medpar/DC/Documentos/Enunciado/1.png

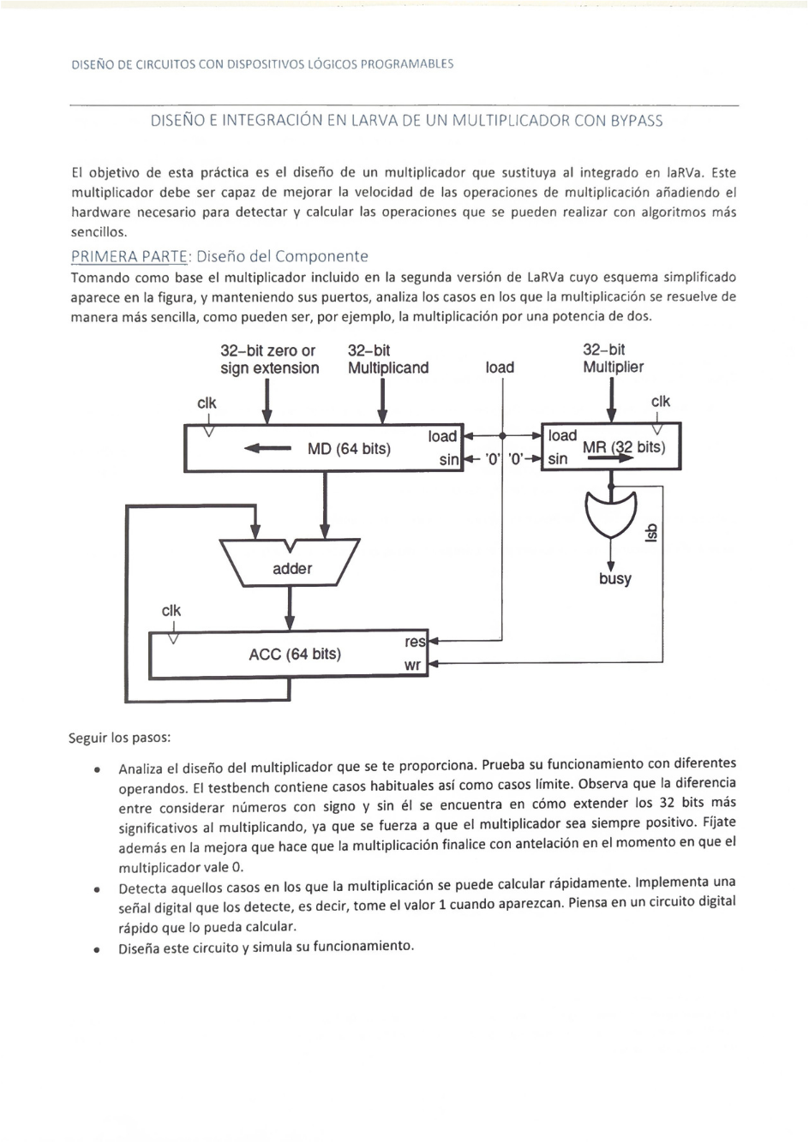
Documentos/Enunciado/1.png
