medpar/DC/Documentos/Enunciado/2.png

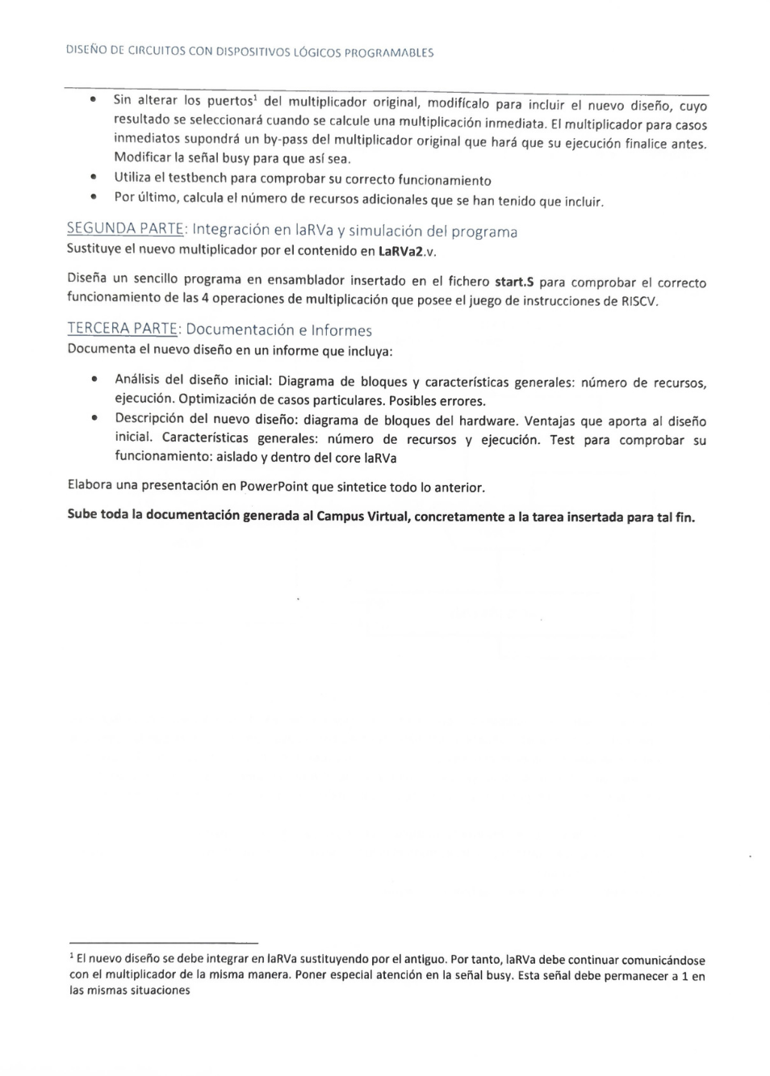
Documentos/Enunciado/2.png
