medpar/DC/Documentos/larva_v2/1.png

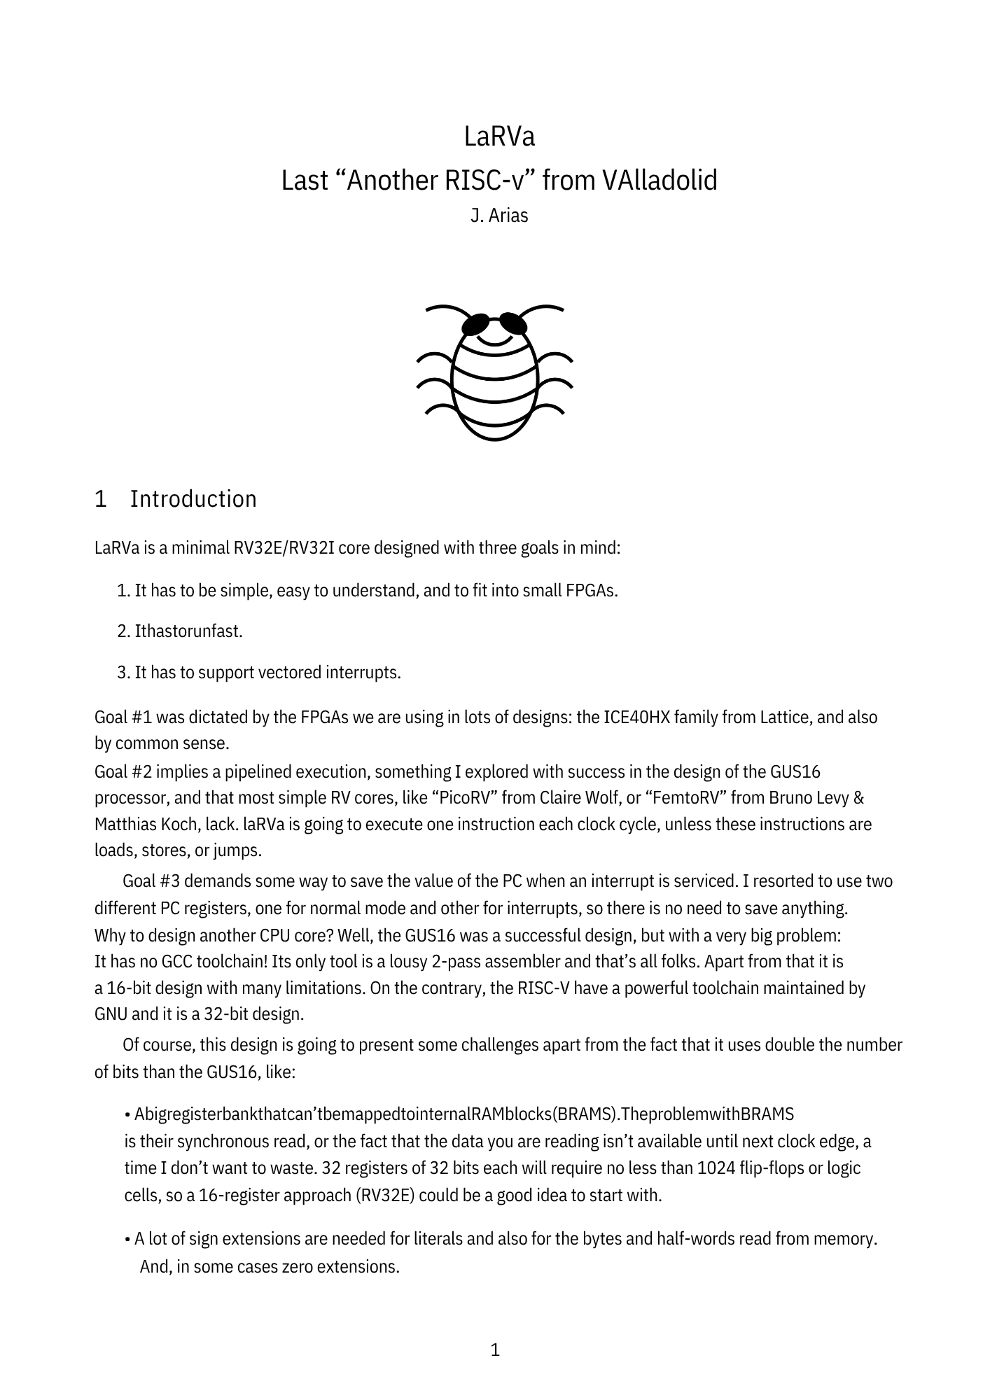
Documentos/larva_v2/1.png
