medpar/DC/Documentos/larva_v2/2.png

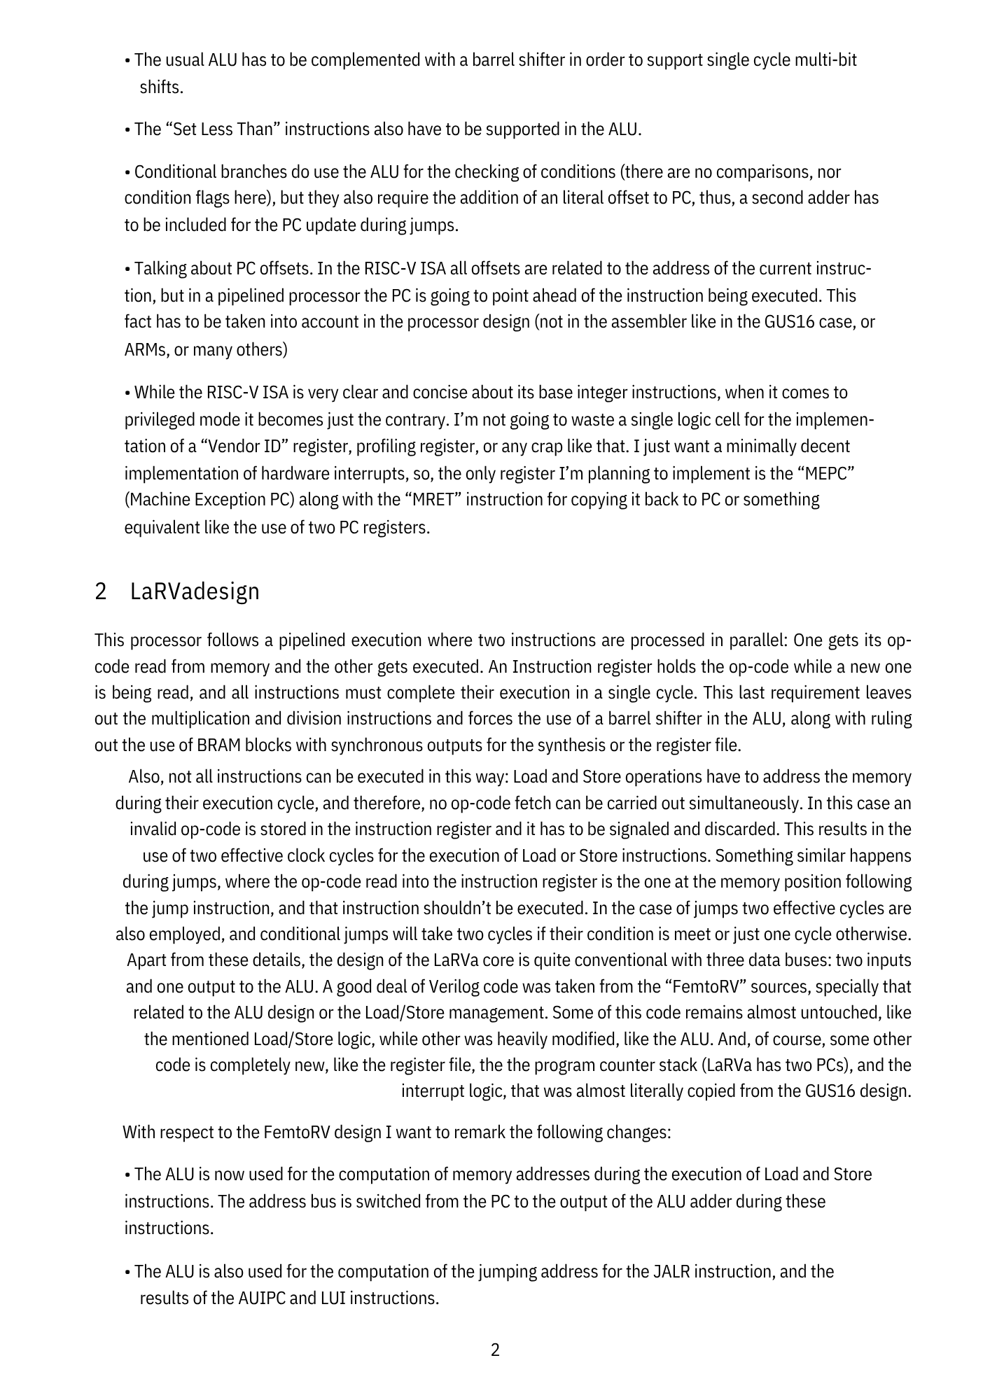
Documentos/larva_v2/2.png
