medpar/DC/Documentos/larva_v2/3.png

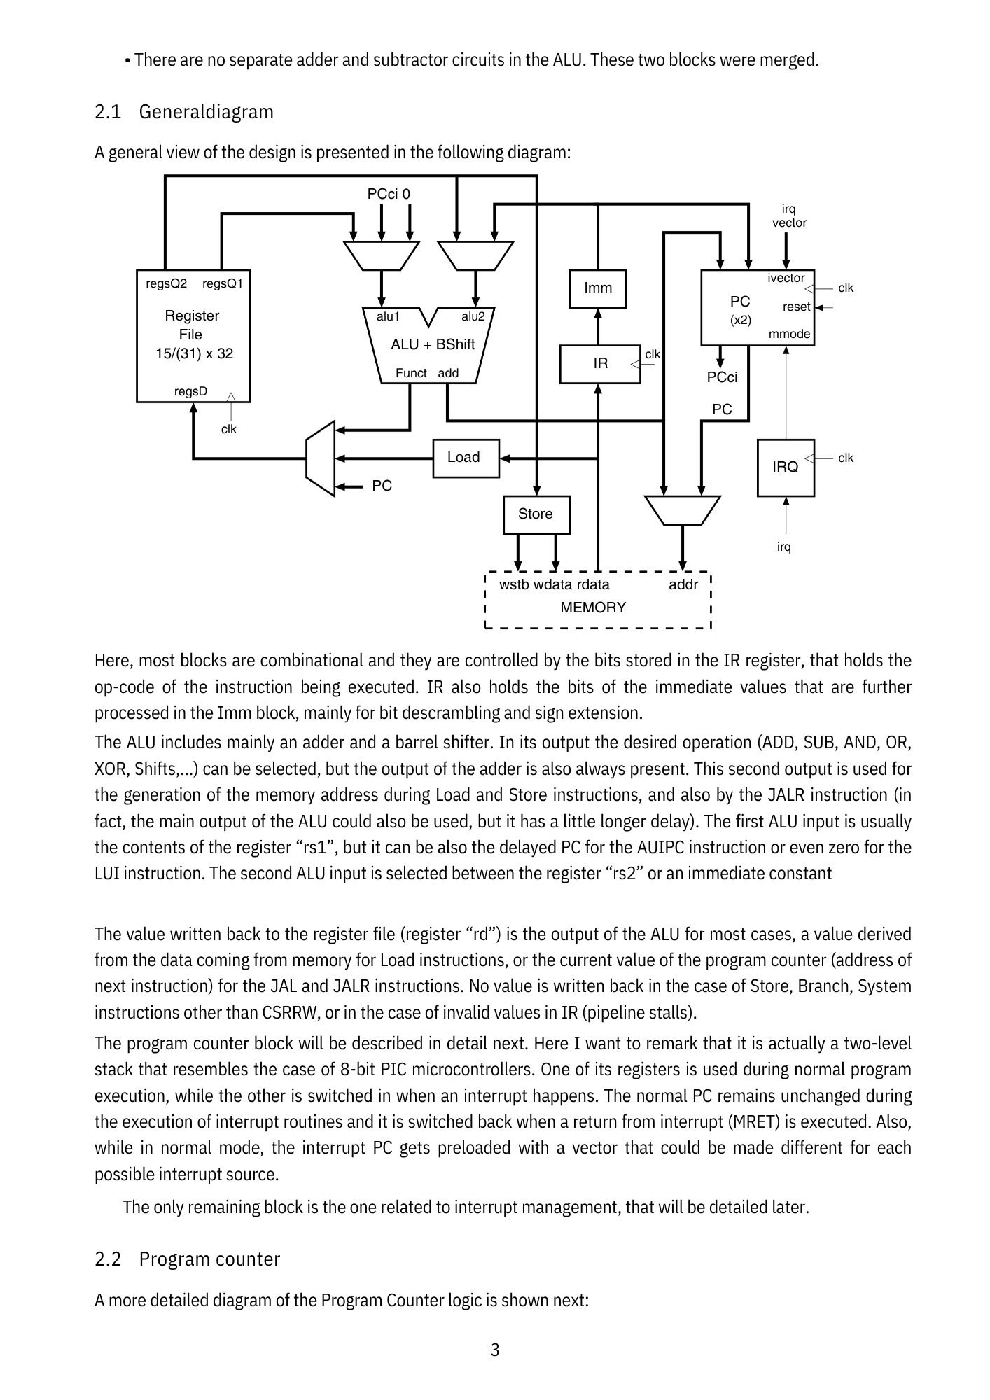
Documentos/larva_v2/3.png
