medpar/DC/Documentos/larva_v2/4.png

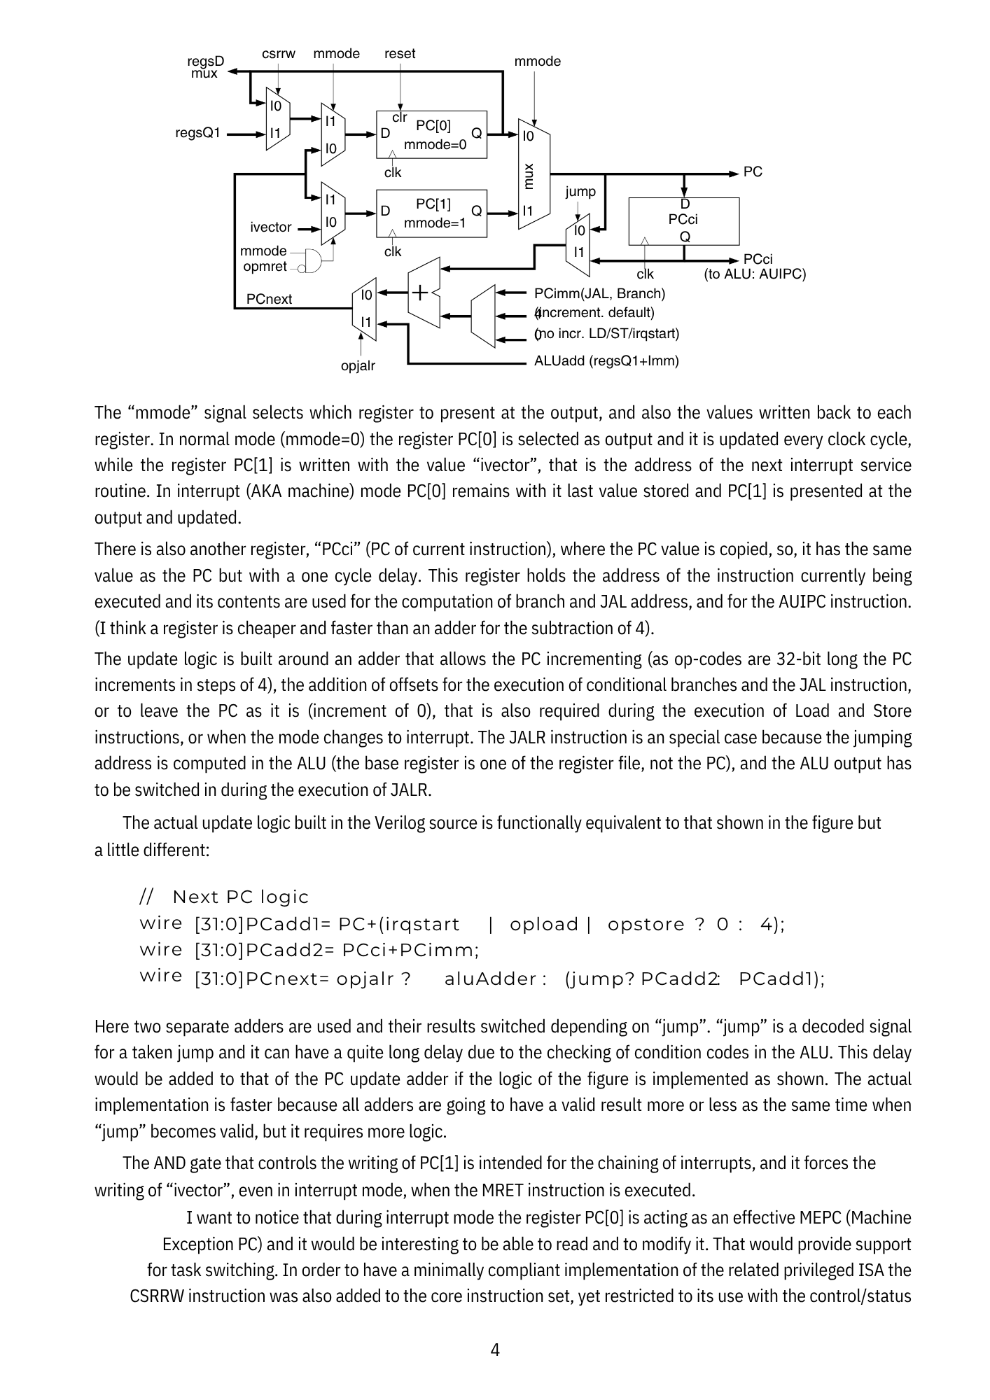
Documentos/larva_v2/4.png
