medpar/DC/Documentos/larva_v2/5.png

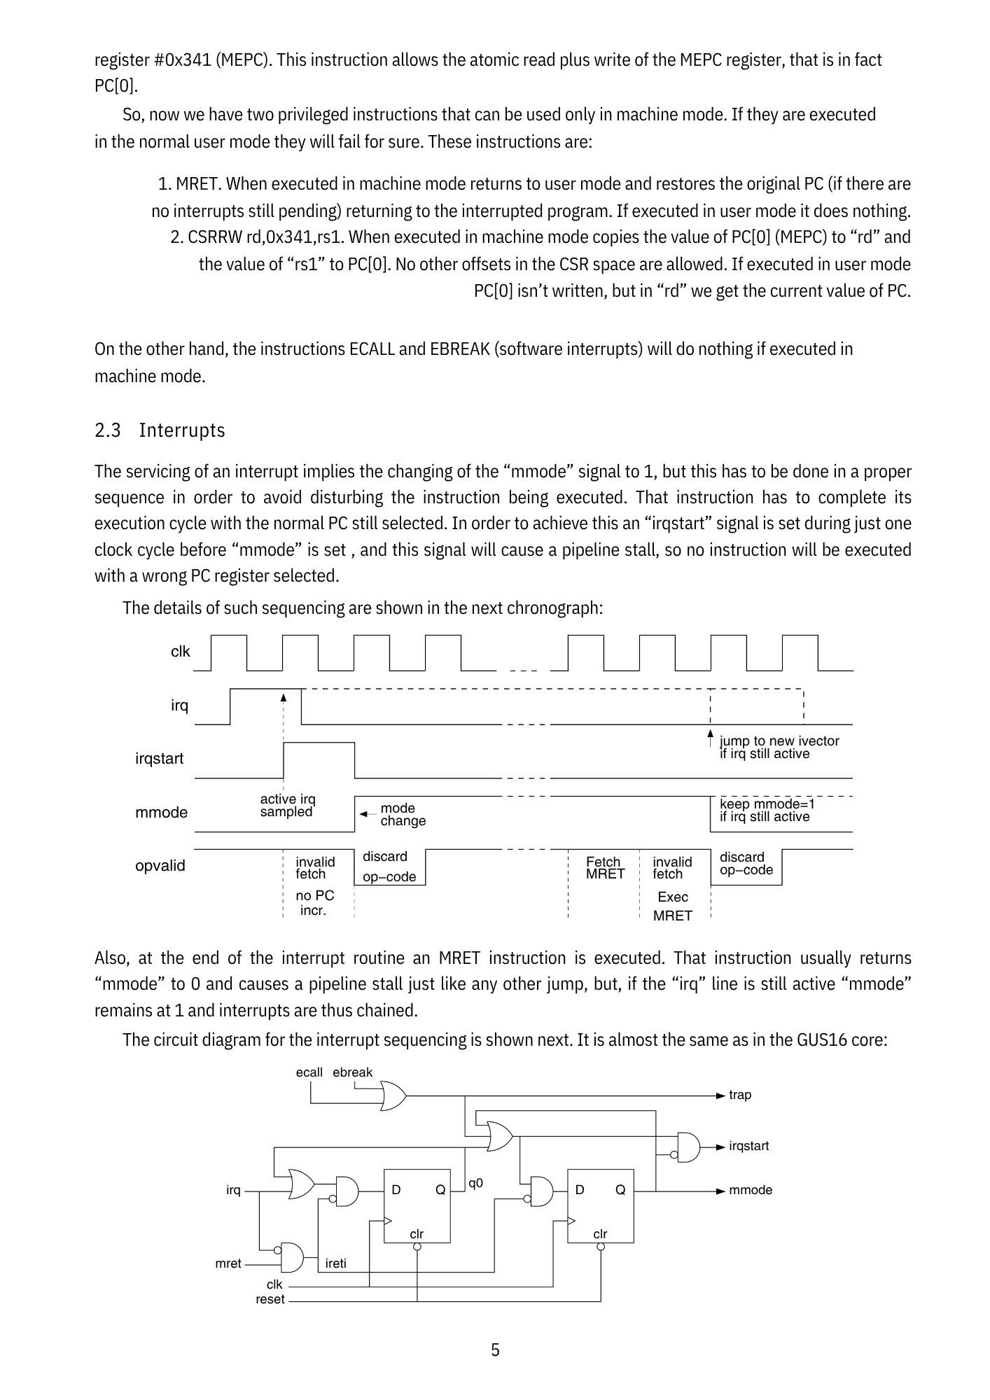
Documentos/larva_v2/5.png
