medpar/DC/Documentos/larva_v2/6.png

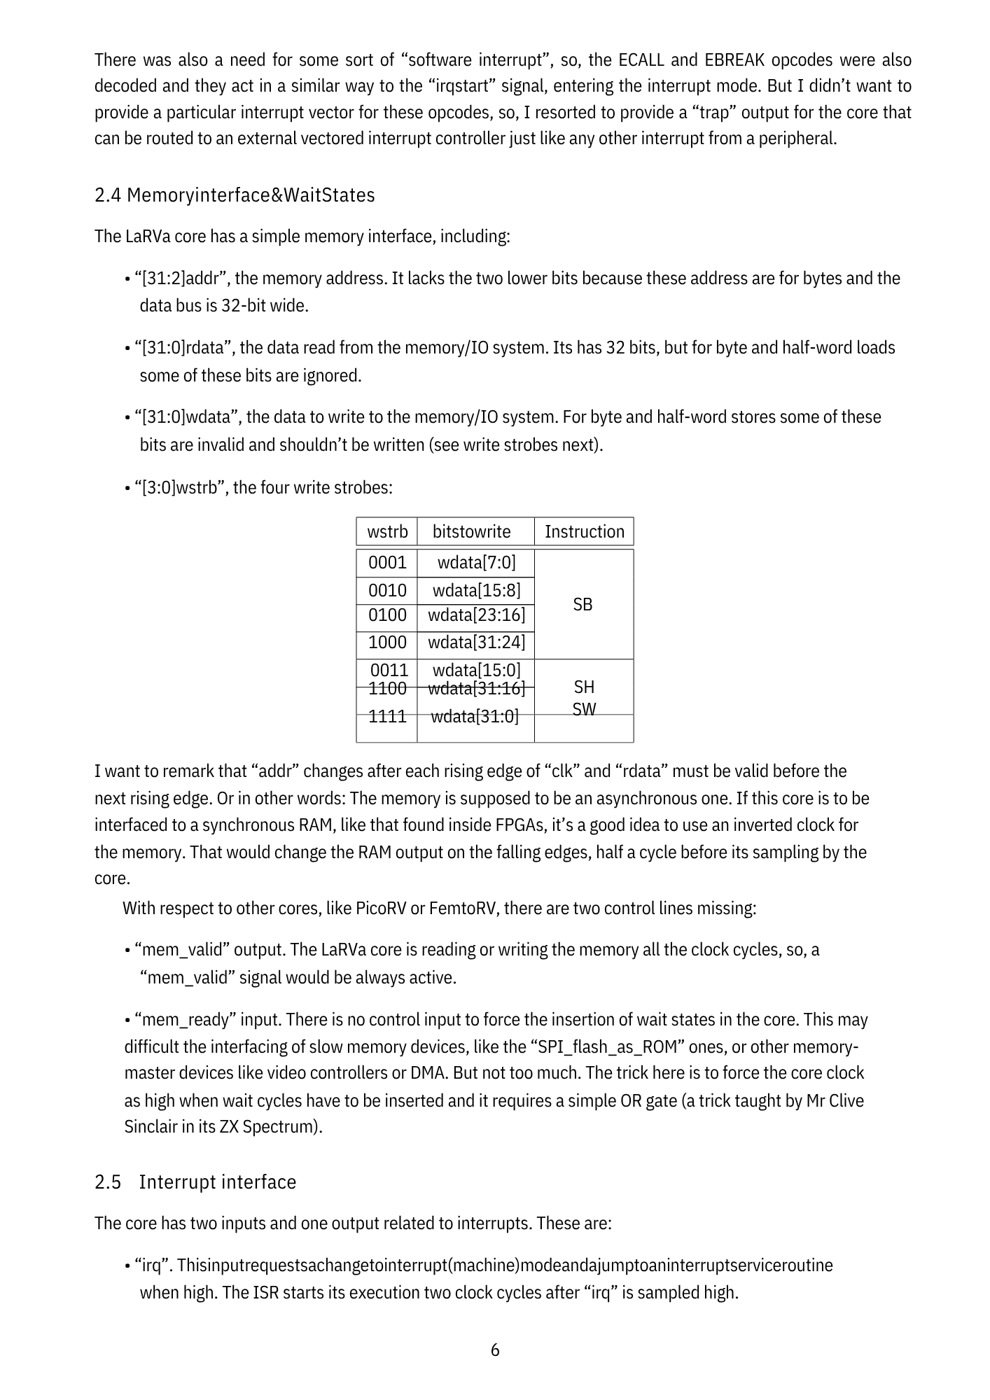
Documentos/larva_v2/6.png
