medpar/DC/Documentos/larva_v2/7.png

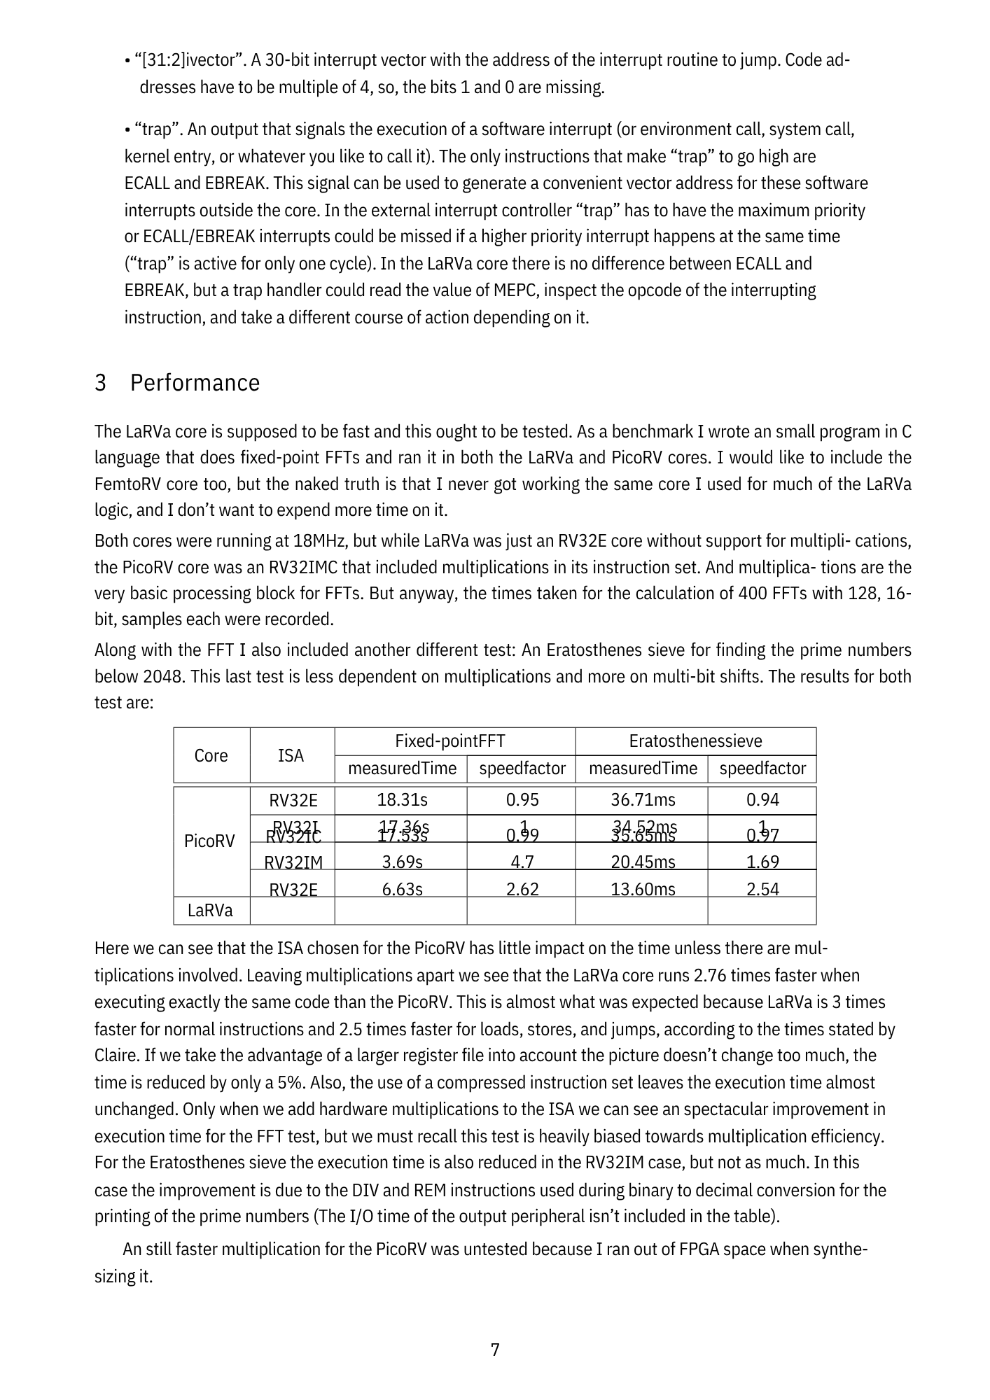
Documentos/larva_v2/7.png
