medpar/DC/Documentos/larva_v2/8.png

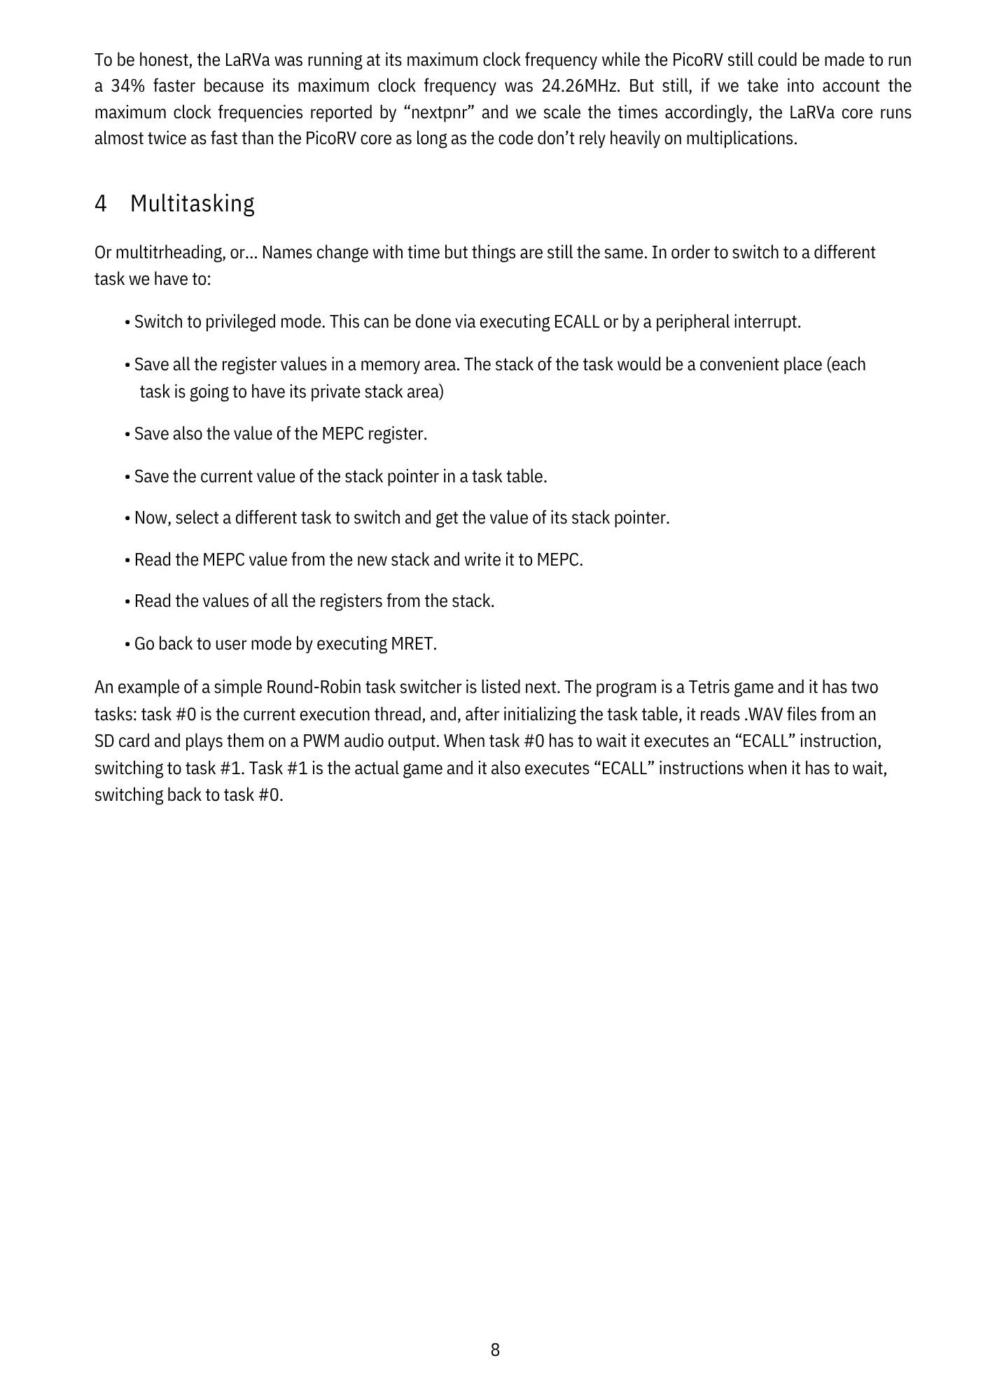
Documentos/larva_v2/8.png
