medpar/DC/Documentos/larva_v2/9.png

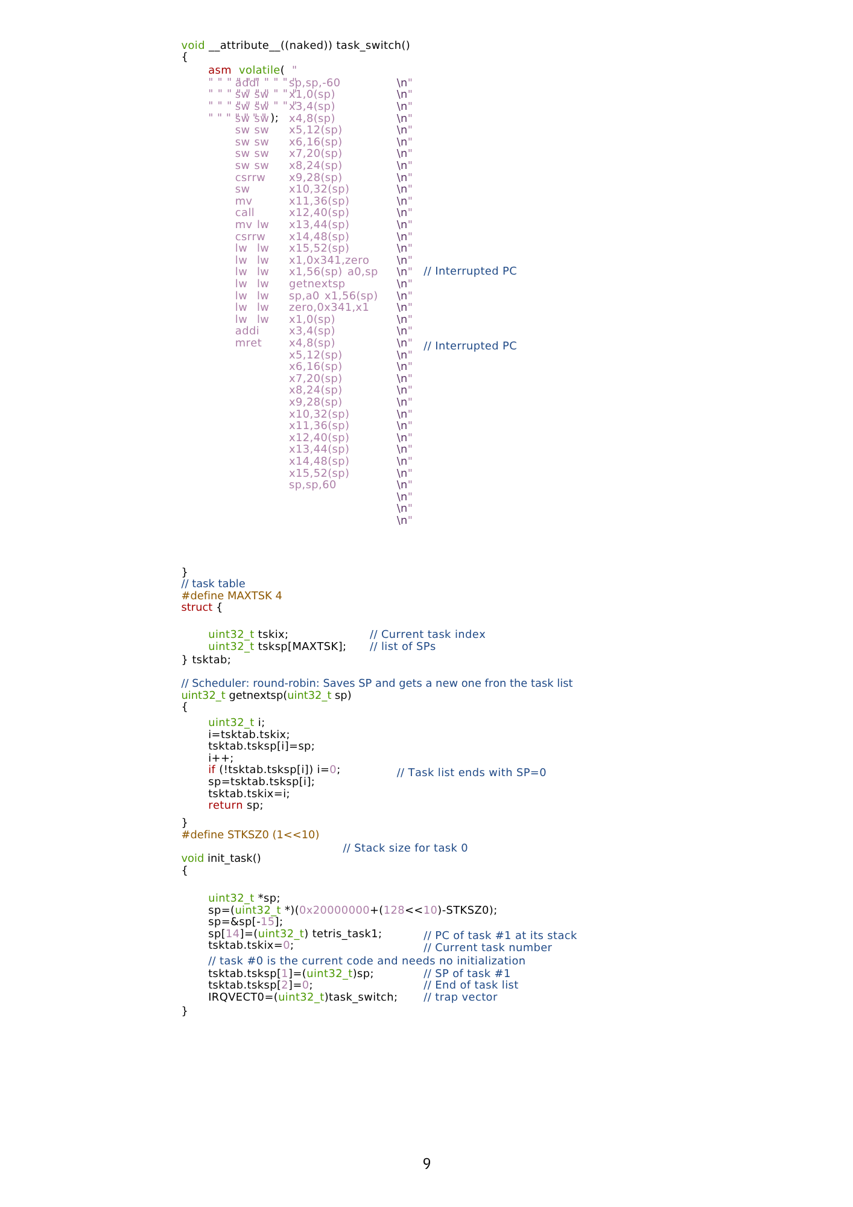
Documentos/larva_v2/9.png
