medpar/DC/Documentos/larva_v2/10.png

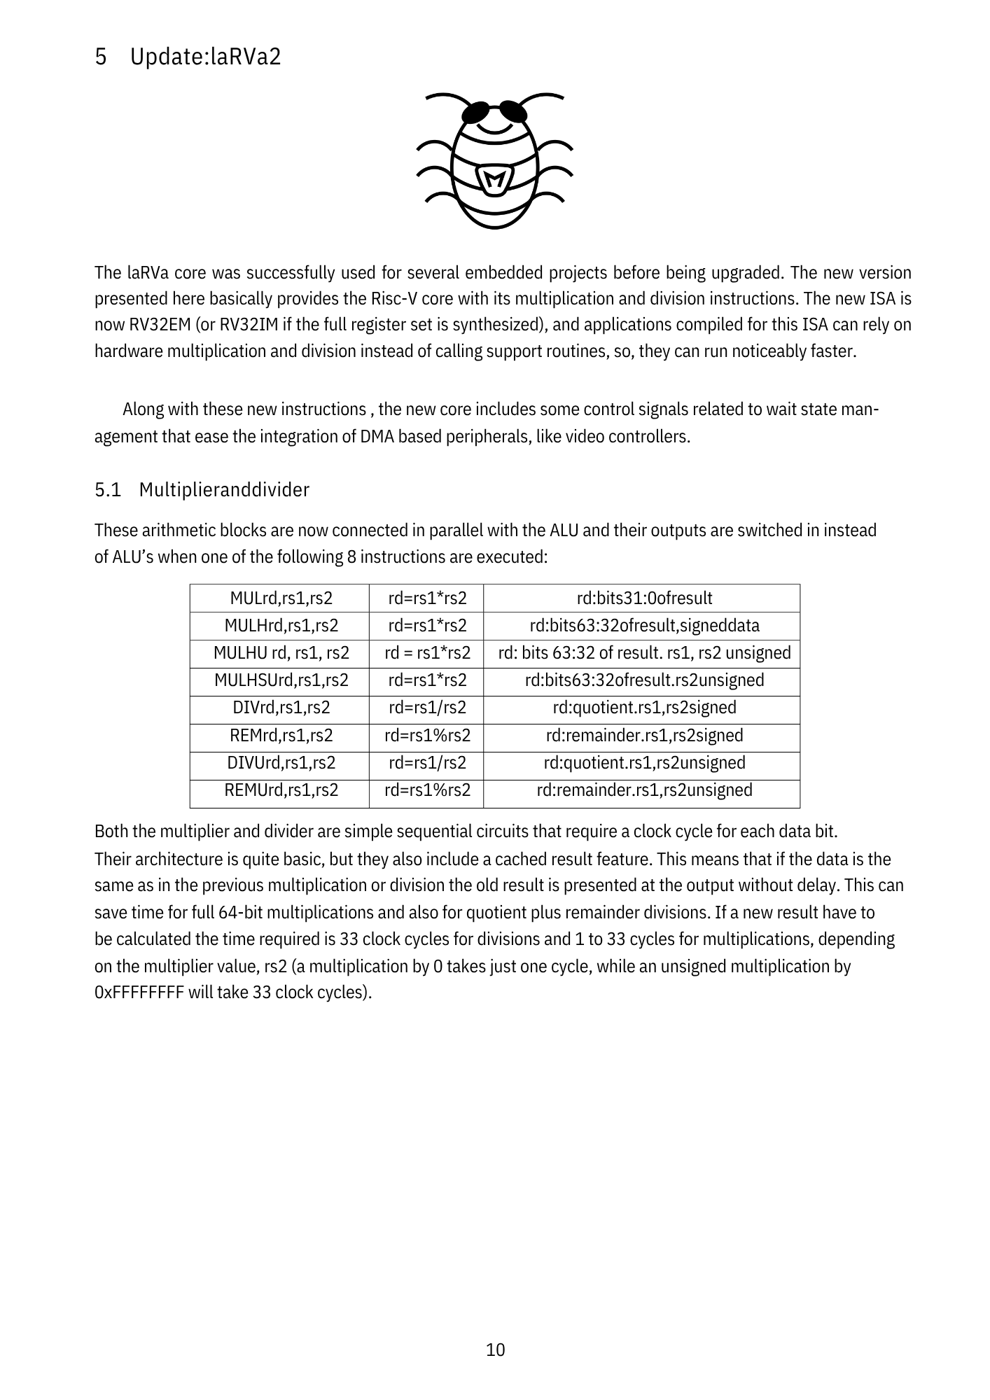
Documentos/larva_v2/10.png
