medpar/DC/Documentos/larva_v2/11.png

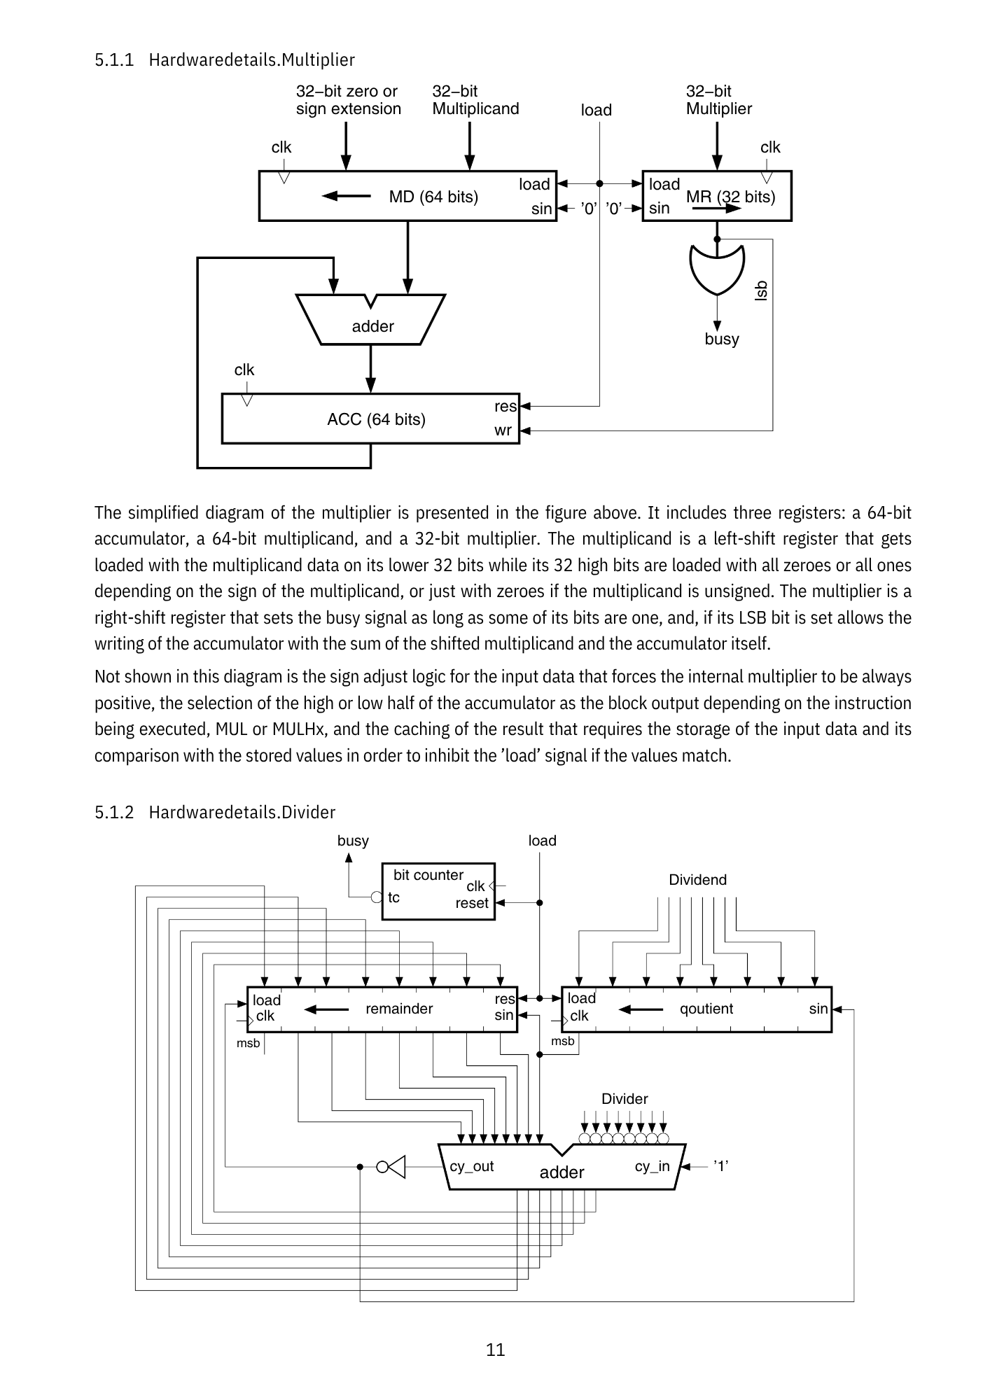
Documentos/larva_v2/11.png
