medpar/DC/Documentos/larva_v2/12.png

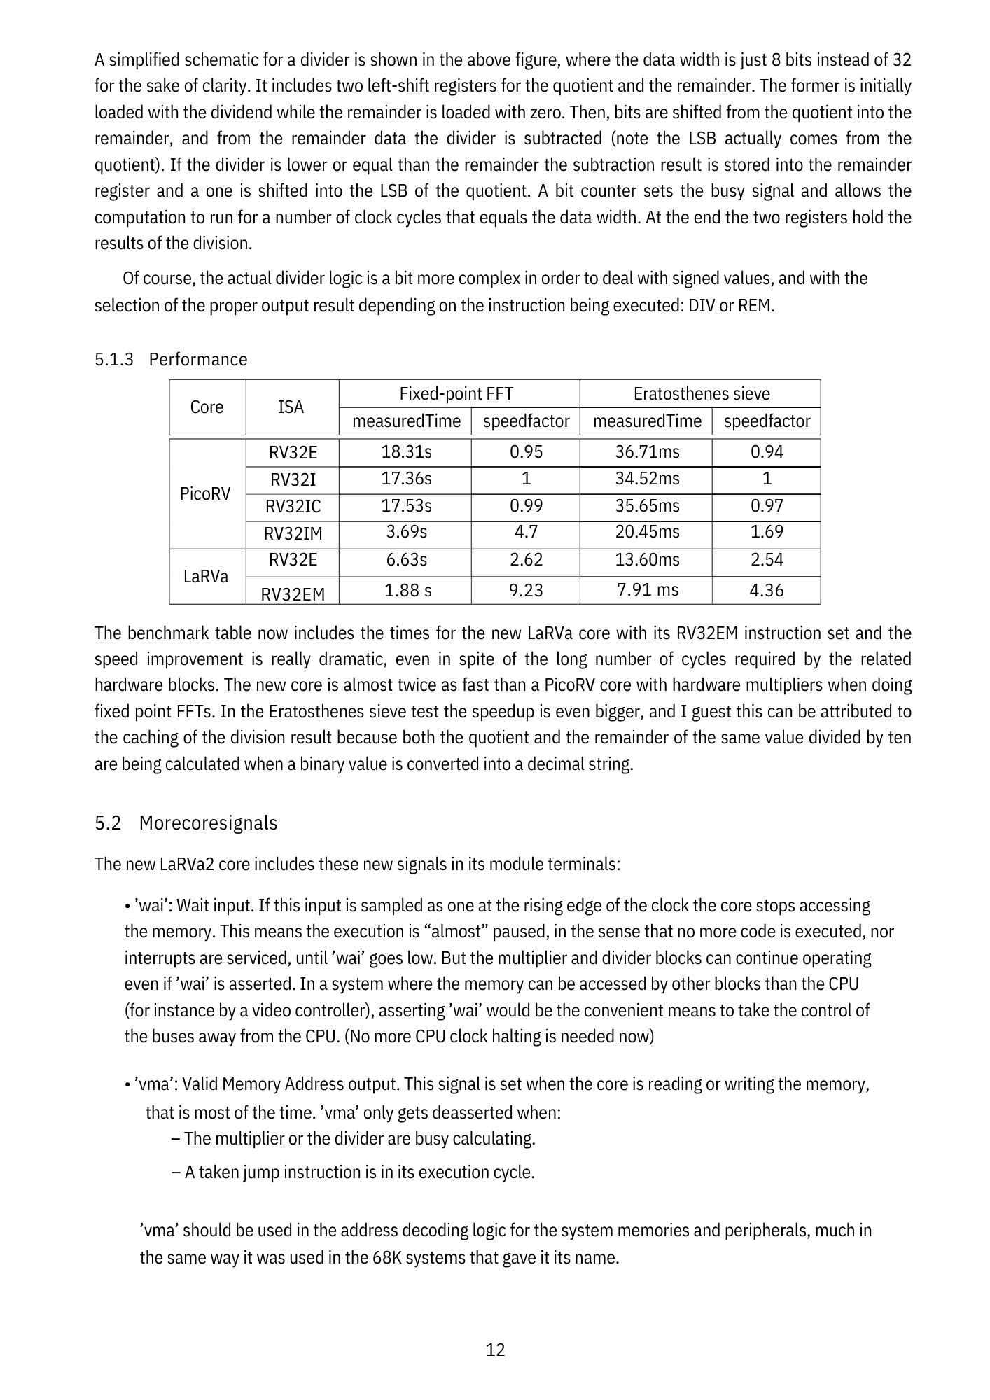
Documentos/larva_v2/12.png
