medpar/DC/Documentos/larva_v2/13.png

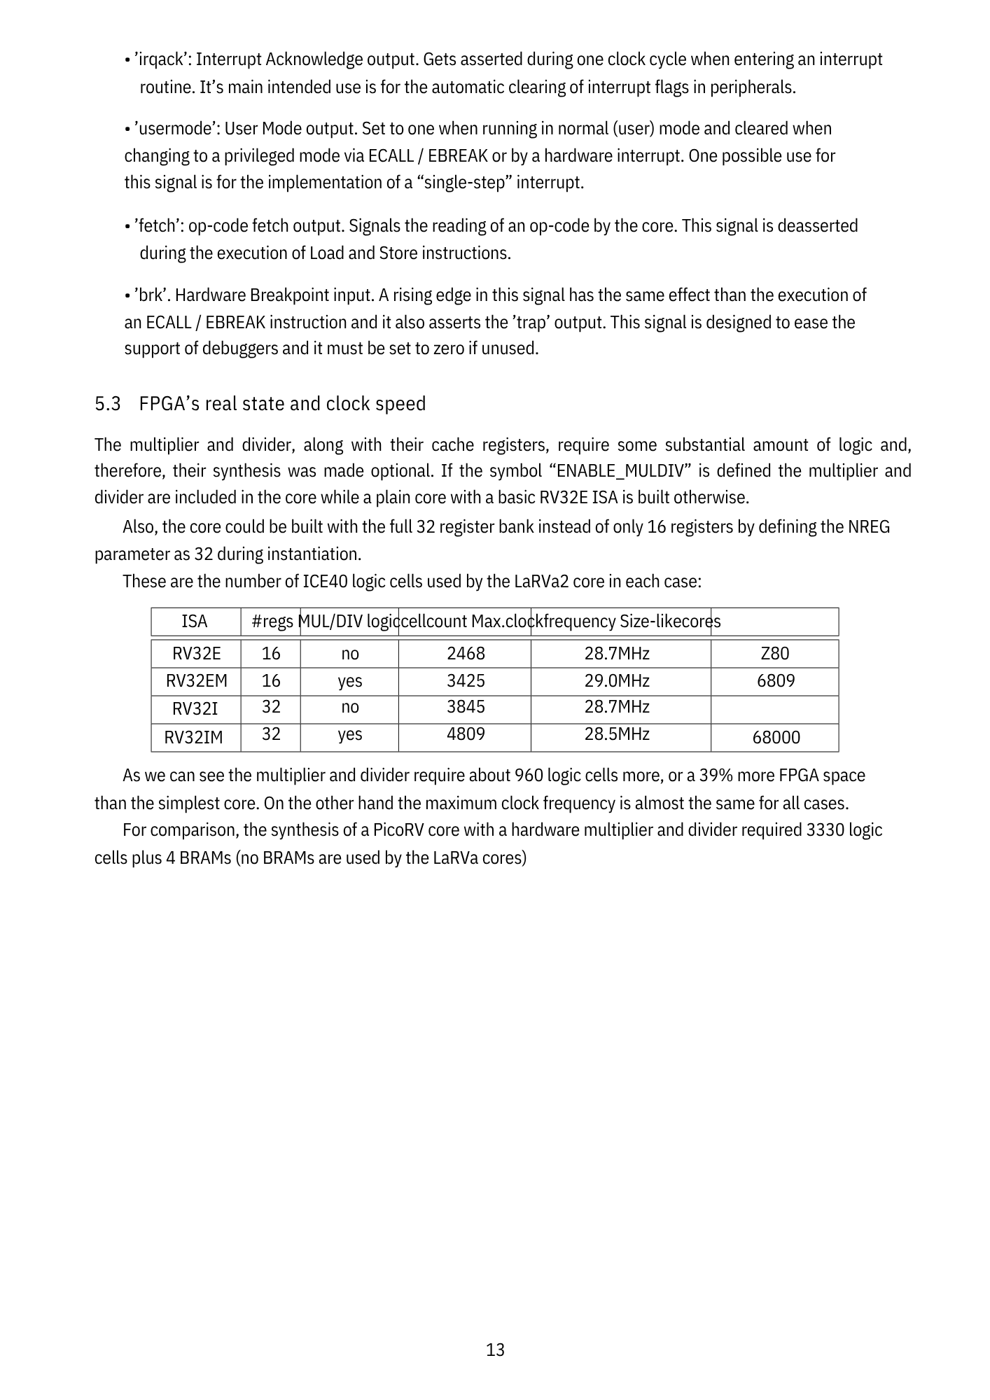
Documentos/larva_v2/13.png
