medpar/DC/Firmware/tv.c

#define NFFT 400

#define L2NS (7)
#define NSAMPLES (1<<L2NS)

unsigned int nmul=0,nadd=0;

typedef short fixed;

int fix_fft(fixed *fr, fixed *fi, int m, int inverse);
void window(fixed *fr, int n);
void fix_loud(fixed *loud, fixed *fr, fixed *fi, int n, int scale_shift);

/*      fix_fft.c - Fixed-point Fast Fourier Transform  */
/*
        fix_fft()       perform FFT or inverse FFT
        window()        applies a Hanning window to the (time) input
        fix_loud()      calculates the loudness of the signal, for
                        each freq point. Result is an integer array,
                        units are dB (values will be negative).
        iscale()        scale an integer value by (numer/denom).
        fix_mpy()       perform fixed-point multiplication.
        Sinewave[1024]  sinewave normalized to 32767 (= 1.0).
        Loudampl2[100]  Square of Amplitudes for lopudnesses from 0 to -99 dB.
        Low_pass        Low-pass filter, cutoff at sample_freq / 4.


        All data are fixed-point short integers, in which
        -32768 to +32768 represent -1.0 to +1.0. Integer arithmetic
        is used for speed, instead of the more natural floating-point.

        For the forward FFT (time -> freq), fixed scaling is
        performed to prevent arithmetic overflow, and to map a 0dB
        sine/cosine wave (i.e. amplitude = 32767) to two -6dB freq
        coefficients; the one in the lower half is reported as 0dB
        by fix_loud(). The return value is always 0.

        For the inverse FFT (freq -> time), fixed scaling cannot be
        done, as two 0dB coefficients would sum to a peak amplitude of
        64K, overflowing the 32k range of the fixed-point integers.
        Thus, the fix_fft() routine performs variable scaling, and
        returns a value which is the number of bits LEFT by which
        the output must be shifted to get the actual amplitude
        (i.e. if fix_fft() returns 3, each value of fr[] and fi[]
        must be multiplied by 8 (2**3) for proper scaling.
        Clearly, this cannot be done within the fixed-point short
        integers. In practice, if the result is to be used as a
        filter, the scale_shift can usually be ignored, as the
        result will be approximately correctly normalized as is.


        TURBO C, any memory model; uses inline assembly for speed
        and for carefully-scaled arithmetic.

        Written by:  Tom Roberts  11/8/89
        Made portable:  Malcolm Slaney 12/15/94 malcolm@interval.com

                Timing on a Macintosh PowerBook 180.... (using Symantec C6.0)
                        fix_fft (1024 points)             8 ticks
                        fft (1024 points - Using SANE)  112 Ticks
                        fft (1024 points - Using FPU)    11

*/

#define N_WAVE          1024    /* dimension of Sinewave[] */
#define LOG2_N_WAVE     10      /* log2(N_WAVE) */

#ifndef fixed
#define fixed int16_t
#endif


#if N_WAVE != 1024
        ERROR: N_WAVE != 1024
#endif
const fixed Sinewave[1024] = {
      0,    201,    402,    603,    804,   1005,   1206,   1406,
   1607,   1808,   2009,   2209,   2410,   2610,   2811,   3011,
   3211,   3411,   3611,   3811,   4011,   4210,   4409,   4608,
   4807,   5006,   5205,   5403,   5601,   5799,   5997,   6195,
   6392,   6589,   6786,   6982,   7179,   7375,   7571,   7766,
   7961,   8156,   8351,   8545,   8739,   8932,   9126,   9319,
   9511,   9703,   9895,  10087,  10278,  10469,  10659,  10849,
  11038,  11227,  11416,  11604,  11792,  11980,  12166,  12353,
  12539,  12724,  12909,  13094,  13278,  13462,  13645,  13827,
  14009,  14191,  14372,  14552,  14732,  14911,  15090,  15268,
  15446,  15623,  15799,  15975,  16150,  16325,  16499,  16672,
  16845,  17017,  17189,  17360,  17530,  17699,  17868,  18036,
  18204,  18371,  18537,  18702,  18867,  19031,  19194,  19357,
  19519,  19680,  19840,  20000,  20159,  20317,  20474,  20631,
  20787,  20942,  21096,  21249,  21402,  21554,  21705,  21855,
  22004,  22153,  22301,  22448,  22594,  22739,  22883,  23027,
  23169,  23311,  23452,  23592,  23731,  23869,  24006,  24143,
  24278,  24413,  24546,  24679,  24811,  24942,  25072,  25201,
  25329,  25456,  25582,  25707,  25831,  25954,  26077,  26198,
  26318,  26437,  26556,  26673,  26789,  26905,  27019,  27132,
  27244,  27355,  27466,  27575,  27683,  27790,  27896,  28001,
  28105,  28208,  28309,  28410,  28510,  28608,  28706,  28802,
  28897,  28992,  29085,  29177,  29268,  29358,  29446,  29534,
  29621,  29706,  29790,  29873,  29955,  30036,  30116,  30195,
  30272,  30349,  30424,  30498,  30571,  30643,  30713,  30783,
  30851,  30918,  30984,  31049,
  31113,  31175,  31236,  31297,
  31356,  31413,  31470,  31525,  31580,  31633,  31684,  31735,
  31785,  31833,  31880,  31926,  31970,  32014,  32056,  32097,
  32137,  32176,  32213,  32249,  32284,  32318,  32350,  32382,
  32412,  32441,  32468,  32495,  32520,  32544,  32567,  32588,
  32609,  32628,  32646,  32662,  32678,  32692,  32705,  32717,
  32727,  32736,  32744,  32751,  32757,  32761,  32764,  32766,
  32767,  32766,  32764,  32761,  32757,  32751,  32744,  32736,
  32727,  32717,  32705,  32692,  32678,  32662,  32646,  32628,
  32609,  32588,  32567,  32544,  32520,  32495,  32468,  32441,
  32412,  32382,  32350,  32318,  32284,  32249,  32213,  32176,
  32137,  32097,  32056,  32014,  31970,  31926,  31880,  31833,
  31785,  31735,  31684,  31633,  31580,  31525,  31470,  31413,
  31356,  31297,  31236,  31175,  31113,  31049,  30984,  30918,
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
};

/*
        fix_mpy() - fixed-point multiplication
*/
extern inline fixed fix_mpy(fixed a, fixed b)
{
return ((long)a*(long)b)>>15;

}

/*
        fix_fft() - perform fast Fourier transform.

        if n>0 FFT is done, if n<0 inverse FFT is done
        fr[n],fi[n] are real,imaginary arrays, INPUT AND RESULT.
        size of data = 2**m
        set inverse to 0=dft, 1=idft
*/
int fix_fft(fixed fr[], fixed fi[], int m, int inverse)
{
        int mr,nn,i,j,l,k,istep, n, scale, shift;
        fixed qr,qi,tr,ti,wr,wi,t;

                n = 1<<m;

        if(n > N_WAVE)
                return -1;

        mr = 0;
        nn = n - 1;
        scale = 0;

        /* decimation in time - re-order data */
        for(m=1; m<=nn; ++m) {
                l = n;
                do {
                        l >>= 1;
                } while(mr+l > nn);
                mr = (mr & (l-1)) + l;

                if(mr <= m) continue;
                tr = fr[m];
                fr[m] = fr[mr];
                fr[mr] = tr;
                ti = fi[m];
                fi[m] = fi[mr];
                fi[mr] = ti;
        }

        l = 1;
        k = LOG2_N_WAVE-1;
        while(l < n) {
                if(inverse) {
                        /* variable scaling, depending upon data */
                        shift = 0;
                        for(i=0; i<n; ++i) {
                                j = fr[i];
                                if(j < 0)
                                        j = -j;
                                m = fi[i];
                                if(m < 0)
                                        m = -m;
                                if(j > 16383 || m > 16383) {
                                        shift = 1;
                                        break;
                                }
                        }
                        if(shift)
                                ++scale;
                } else {
                        /* fixed scaling, for proper normalization -
                           there will be log2(n) passes, so this
                           results in an overall factor of 1/n,
                           distributed to maximize arithmetic accuracy. */
                        shift = 1;
                }
                /* it may not be obvious, but the shift will be performed
                   on each data point exactly once, during this pass. */
                istep = l << 1;
                for(m=0; m<l; ++m) {
                        j = m << k;
                        /* 0 <= j < N_WAVE/2 */
                        wr =  Sinewave[j+N_WAVE/4];
                        wi = -Sinewave[j];
                        if(inverse)
                                wi = -wi;
                        if(shift) {
                                wr >>= 1;
                                wi >>= 1;
                        }
                        for(i=m; i<n; i+=istep) {
                                j = i + l;
                                        tr = fix_mpy(wr,fr[j]) - fix_mpy(wi,fi[j]);
                                        ti = fix_mpy(wr,fi[j]) + fix_mpy(wi,fr[j]);
                                qr = fr[i];
                                qi = fi[i];
                                if(shift) {
                                        qr >>= 1;
                                        qi >>= 1;
                                }
                                fr[j] = qr - tr;
                                fi[j] = qi - ti;
                                fr[i] = qr + tr;
                                fi[i] = qi + ti;
                                //nmul+=4; nadd+=6;
                        }
                }
                --k;
                l = istep;
        }

        //printf("nmul=%d nadd=%d\n",nmul,nadd);
        //exit(0);
        return scale;
}

static unsigned long _srand=12345;
int _rand()
{
    _srand=_srand* 1103515245 + 12345;
    return (_srand>>16)&0x7fff;
}

void tv()
{
	unsigned int i,j,t0,t1;

	fixed far[NSAMPLES],fai[NSAMPLES],fb[NSAMPLES];
	
    _puts("Testing ");

	for (i=0;i<NSAMPLES;i++) fb[i]=_rand();
	
	t0=TCNT;
	for(i=0;i<NFFT;i++) {
		_putch('.');
		for(j=0;j<NSAMPLES;j++) {far[j]=fb[j]; fai[j]=0;}
		fix_fft(far,fai, L2NS, 0);
	}
	t0=TCNT-t0; t0/=(CCLK/1000);
	_printf("\n%d ms\n",t0);
}
