medpar/DC/(commit log)

2025-11-19 PRIMERA PARTE implementada y documentada (0 errores en el tb)
    [larva2_backup.v, mult_signo.v]
2025-11-19 Actualizado start.s para que tenga los mismos tests que el testbench
2026-06-21 Add project README with diagrams for portfolio display
    Document the bypass multiplier project: motivation, original design and
    its limitations, the new two-path architecture, the fast-path cases, the
    correctness and latency results, verification, build flow and credits.
    Includes block diagrams, ASM chart and a waveform extracted from the
    project reports.
